pcm52/DRO-V6/README.md

# DRO-V6
Digital Readout sketch files for the Arduino IDE

Schematic and PCB layout files for both the DRO and Encoder boards in Eagle format.

See pcm52.com for more details on construction.
