pcm52/DRO-V6/encoder8.brd

## EAGLE design encoder8.brd (2020-05-19)

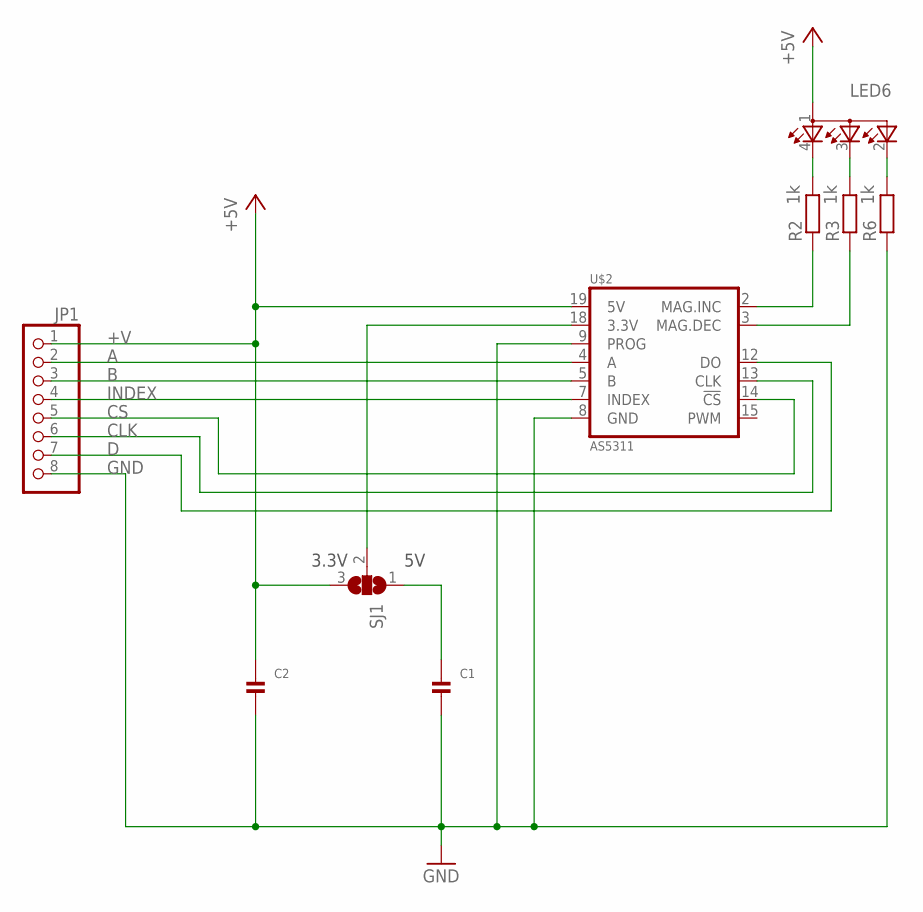
[picture p1: schematic encoder8.sch]

Parts:
C1, C2: CAP_CERAMIC0805; 0805
JP1: PINHD-1X8BIG; 1X08-BIG
LED6: RGB; RGB_LED_0805
R2, R3, R6: 1k; M0805
SJ1: SJ2W; SJ_2
U$2: AS5311; TSSOP.20

Connections:
+5V: LED6.1 (CA)
+V: C2.1, JP1.1, SJ1.3, U$2.19 (5V)
A: JP1.2, U$2.4 (A)
B: JP1.3, U$2.5 (B)
CLK: JP1.6, U$2.13 (CLK)
CS: JP1.5, U$2.14 (!CS)
D: JP1.7, U$2.12 (DO)
DEC: R3.1, U$2.3 (MAG.DEC)
GND: C1.2, C2.2, JP1.8, R6.1, U$2.8 (GND), U$2.9 (PROG)
INC: R2.1, U$2.2 (MAG.INC)
INDEX: JP1.4, U$2.7 (INDEX)
unnamed: C1.1, SJ1.1
unnamed: LED6.4 (CRED), R2.2
unnamed: LED6.3 (CGREEN), R3.2
unnamed: LED6.2 (CBLUE), R6.2
unnamed: SJ1.2, U$2.18 (3.3V)

Notes on the sheet:
3.3V

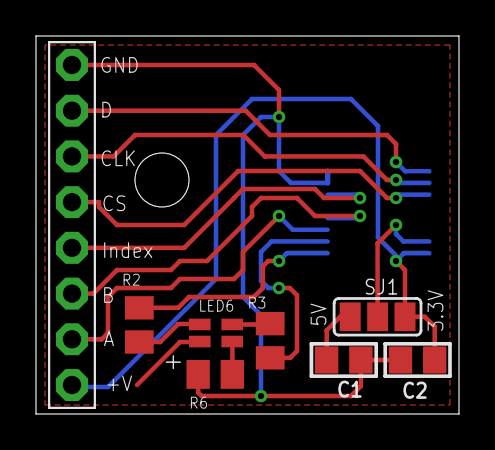
[picture p2: board encoder8.brd from above]

Board: 2 copper layers, 23.5 x 21.0 mm, 9 parts (1 on the bottom side), 15 nets.
