pcm52/DRO-V6/2.2_128x32_OLED-SPI-DRO-FTDI-6.brd

## EAGLE design 2.2_128x32_OLED-SPI-DRO-FTDI-6.brd (2020-05-19)

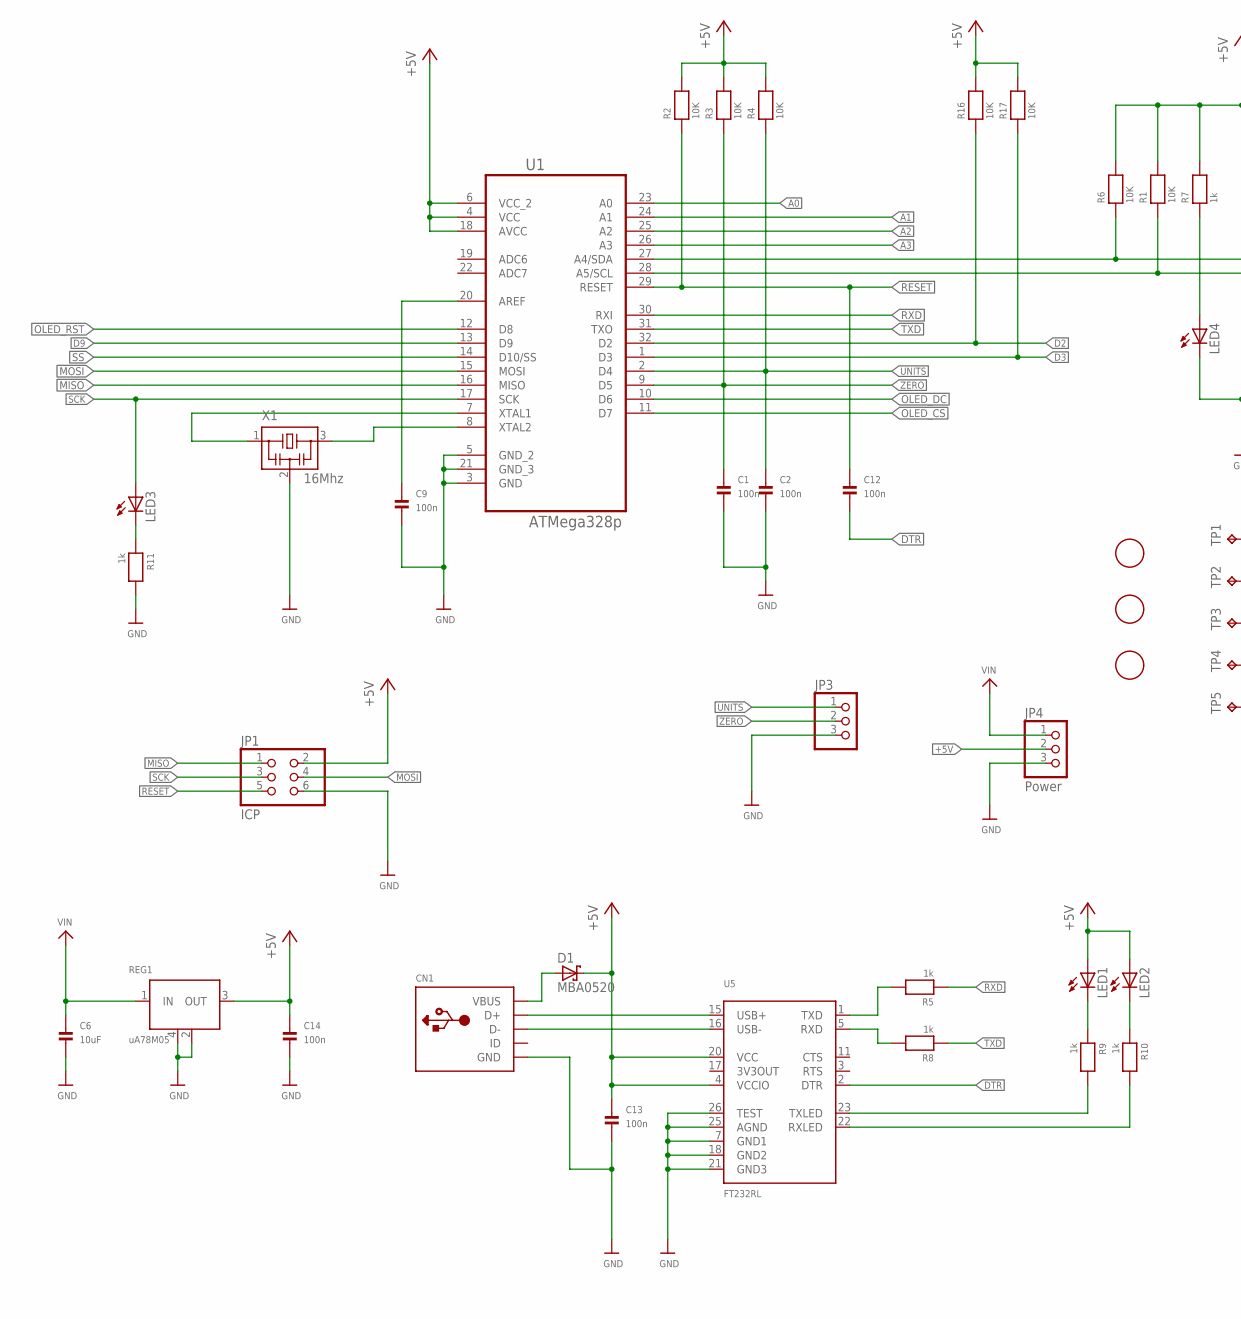
[picture p3: schematic 2.2_128x32_OLED-SPI-DRO-FTDI-6.sch, part in row 1, column 1]

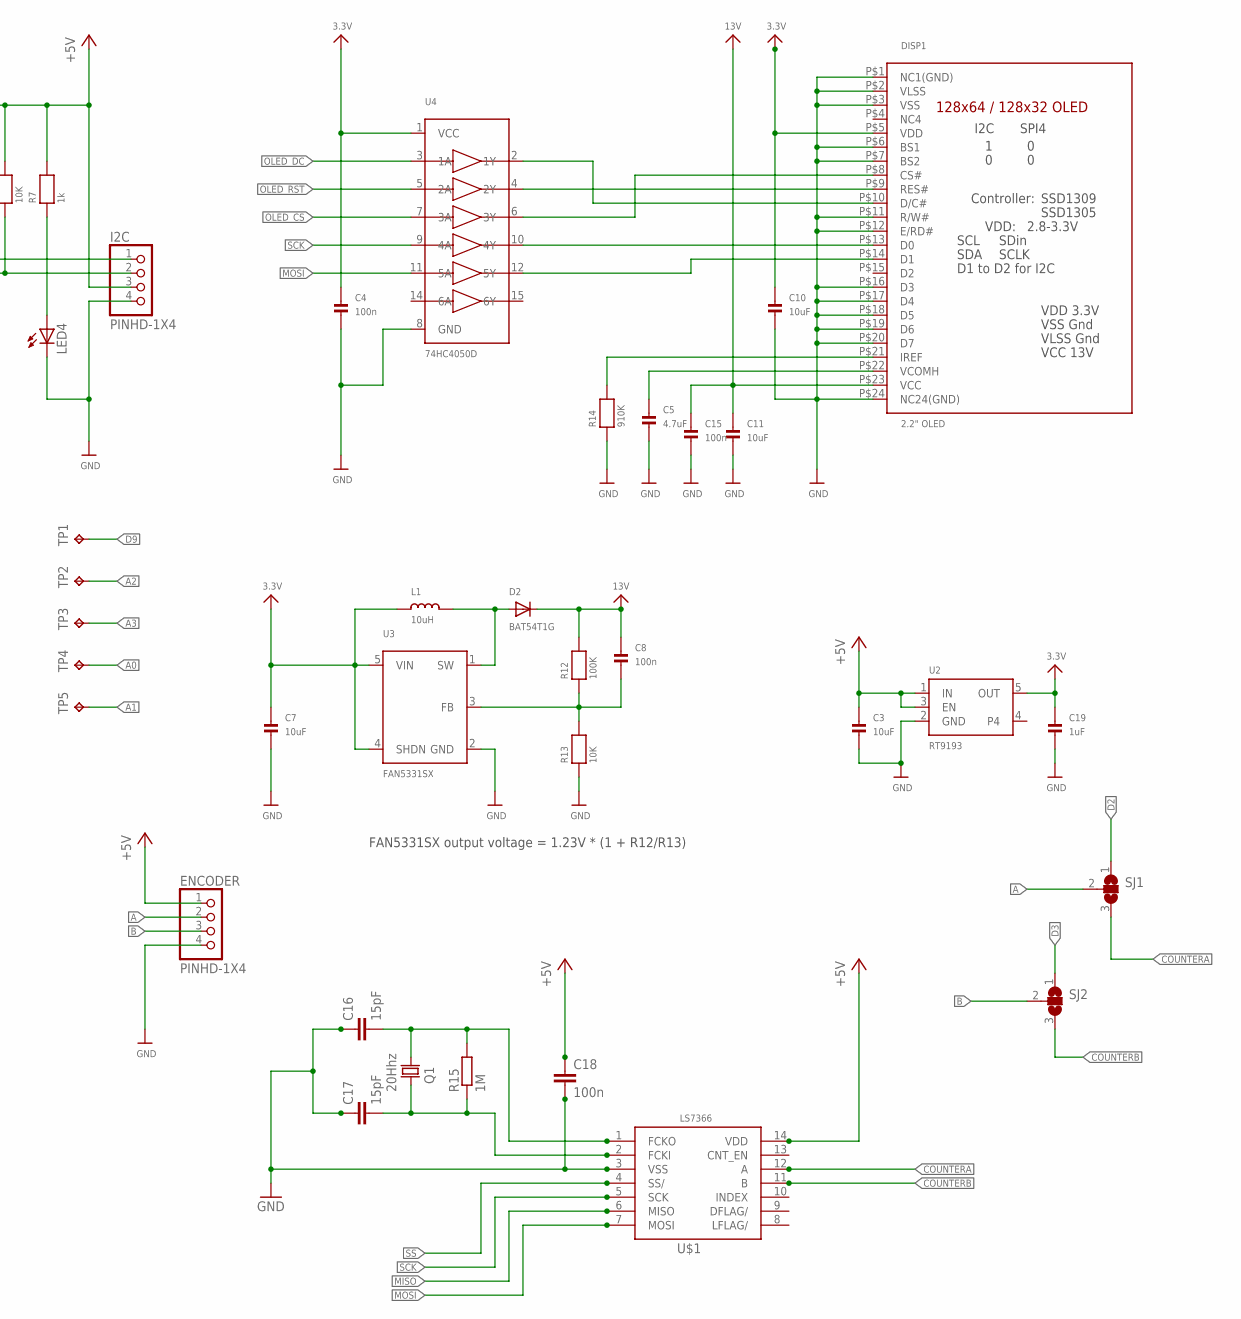
[picture p4: schematic 2.2_128x32_OLED-SPI-DRO-FTDI-6.sch, part in row 1, column 2]

Parts:
C1, C2, C4, C8, C9, C12, C13, C14, C15: 100n; 0805
C3, C6, C7, C10, C11: 10uF; 0805
C5: 4.7uF; 0805
C16, C17: 15pF; C0805
C18: 100n; C0805
C19: 1uF; 0805
CN1: USBMINIB; USB-MINIB
D1: MBA0520; SOD123
D2: BAT54T1G; SOD-123
DISP1: 2.2" OLED; 1.5-128X64-TOP-CONTACT
ENCODER: PINHD-1X4; 1X04-BIG
I2C: PINHD-1X4; 1X04-BIG
JP1: ICP; 2X03
JP3: PINHD-1X3; 1X03
JP4: Power; 1X03
L1: 10uH; INDUCTOR_1007
LED1, LED2, LED3, LED4: LEDCHIPLED_0805; CHIPLED_0805
Q1: 20Hhz; F6-XTAL
R1, R2, R3, R4, R6, R13, R16, R17: 10K; 0805
R5, R7, R8, R9, R10, R11: 1k; 0805
R12: 100K; 0805
R14: 910K; 0805
R15: 1M; M0805
REG1: uA78M05; UA78M05
SJ1, SJ2: SJ2W; SJ_2
TP1, TP2, TP3, TP4, TP5: TPTP08R; TP08R
U1: ATMega328p; TQFP-32
U2: RT9193; SOT23-5
U3: FAN5331SX; SOT23-5
U4: 74HC4050D; SOIC16
U5: FT232RL; SSOP28DB
U$1: LS7366; SO14
U$2, U$6, U$28: FIDUCIAL; FIDUCIAL_1MM
X1: 16Mhz; CSTCE-CRYSTAL-OSC

Connections:
3.3V: C4.1, C7.1, C10.1, C19.1, DISP1.P$5 (VDD), L1.P$1 (1), U2.5 (OUT), U3.4 (SHDN), U3.5 (VIN), U4.1 (VCC)
3V3OUT: U5.17 (3V3OUT)
13V: C8.1, C11.1, C15.1, D2.C, DISP1.P$23 (VCC), R12.2
+5V: C3.1, C13.1, C14.1, C18.1, D1.C, ENCODER.1, I2C.3, JP1.2, JP4.2, LED1.A, LED2.A, R1.2, R2.2, R3.2, R4.2, R6.2, R7.2, R16.2, R17.2, REG1.3 (OUT), U1.4 (VCC), U1.6 (VCC_2), U1.18 (AVCC), U2.1 (IN), U2.3 (EN), U5.4 (VCCIO), U5.20 (VCC), U$1.14 (VDD)
A: ENCODER.2, SJ1.2
A0: TP4.TP, U1.23 (A0)
A1: TP5.TP, U1.24 (A1)
A2: TP2.TP, U1.25 (A2)
A3: TP3.TP, U1.26 (A3)
B: ENCODER.3, SJ2.2
COUNTERA: SJ1.3, U$1.12 (A)
COUNTERB: SJ2.3, U$1.11 (B)
CS: DISP1.P$8 (CS#), U4.6 (3Y)
D0: DISP1.P$13 (D0), U4.10 (4Y)
D1: DISP1.P$14 (D1), U4.12 (5Y)
D2: R16.1, SJ1.1, U1.32 (D2)
D3: R17.1, SJ2.1, U1.1 (D3)
D9: TP1.TP, U1.13 (D9)
DC: DISP1.P$10 (D/C#), U4.2 (1Y)
DTR: C12.2, U5.2 (DTR)
GND: C1.2, C2.2, C3.2, C4.2, C5.2, C6.2, C7.2, C9.2, C10.2, C11.2, C13.2, C14.2, C15.2, C16.1, C17.1, C18.2, C19.2, CN1.GND, DISP1.P$1 (NC1(GND)), DISP1.P$2 (VLSS), DISP1.P$3 (VSS), DISP1.P$6 (BS1), DISP1.P$7 (BS2), DISP1.P$11 (R/W#), DISP1.P$12 (E/RD#), DISP1.P$16 (D3), DISP1.P$17 (D4), DISP1.P$18 (D5), DISP1.P$19 (D6), DISP1.P$20 (D7), DISP1.P$24 (NC24(GND)), ENCODER.4, I2C.4, JP1.6, JP3.3, JP4.3, LED4.C, R11.2, R13.1, R14.1, REG1.2 (COMMON1), REG1.4 (COMMON2), U1.3 (GND), U1.5 (GND_2), U1.21 (GND_3), U2.2 (GND), U3.2 (GND), U4.8 (GND), U5.7 (GND1), U5.18 (GND2), U5.21 (GND3), U5.25 (AGND), U5.26 (TEST), U$1.3 (VSS), X1.2
MISO: JP1.1, U1.16 (MISO), U$1.6 (MISO)
MOSI: JP1.4, U1.15 (MOSI), U4.11 (5A), U$1.7 (MOSI)
unnamed: D2.A, L1.P$2 (2), U3.1 (SW)
unnamed: U1.7 (XTAL1), X1.1
unnamed: DISP1.P$21 (IREF), R14.2
unnamed: C8.2, R12.1, R13.2, U3.3 (FB)
unnamed: C5.1, DISP1.P$22 (VCOMH)
unnamed: U1.8 (XTAL2), X1.3
unnamed: C9.1, U1.20 (AREF)
unnamed: CN1.D+, U5.15 (USB+)
unnamed: CN1.D-, U5.16 (USB-)
unnamed: CN1.VBUS, D1.A
unnamed: R5.2, U5.1 (TXD)
unnamed: R8.2, U5.5 (RXD)
unnamed: R9.2, U5.23 (TXLED)
unnamed: R10.2, U5.22 (RXLED)
unnamed: LED3.C, R11.1
unnamed: LED1.C, R9.1
unnamed: LED2.C, R10.1
unnamed: LED4.A, R7.1
unnamed: C16.2, Q1.P$2 (2), R15.2, U$1.1 (FCKO)
unnamed: C17.2, Q1.P$1 (1), R15.1, U$1.2 (FCKI)
OLED_CS: U1.11 (D7), U4.7 (3A)
OLED_DC: U1.10 (D6), U4.3 (1A)
OLED_RST: U1.12 (D8), U4.5 (2A)
RES: DISP1.P$9 (RES#), U4.4 (2Y)
RESET: C12.1, JP1.5, R2.1, U1.29 (RESET)
RXD: R5.1, U1.30 (RXI)
SCK: JP1.3, LED3.A, U1.17 (SCK), U4.9 (4A), U$1.5 (SCK)
SCL: I2C.2, R1.1, U1.28 (A5/SCL)
SDA: I2C.1, R6.1, U1.27 (A4/SDA)
SS: U1.14 (D10/SS), U$1.4 (SS/)
TXD: R8.1, U1.31 (TXO)
UNITS: C2.1, JP3.1, R4.1, U1.2 (D4)
VIN: C6.1, JP4.1, REG1.1 (IN)
ZERO: C1.1, JP3.2, R3.1, U1.9 (D5)

Notes on the sheet:
FAN5331SX output voltage = 1.23V * (1 + R12/R13)

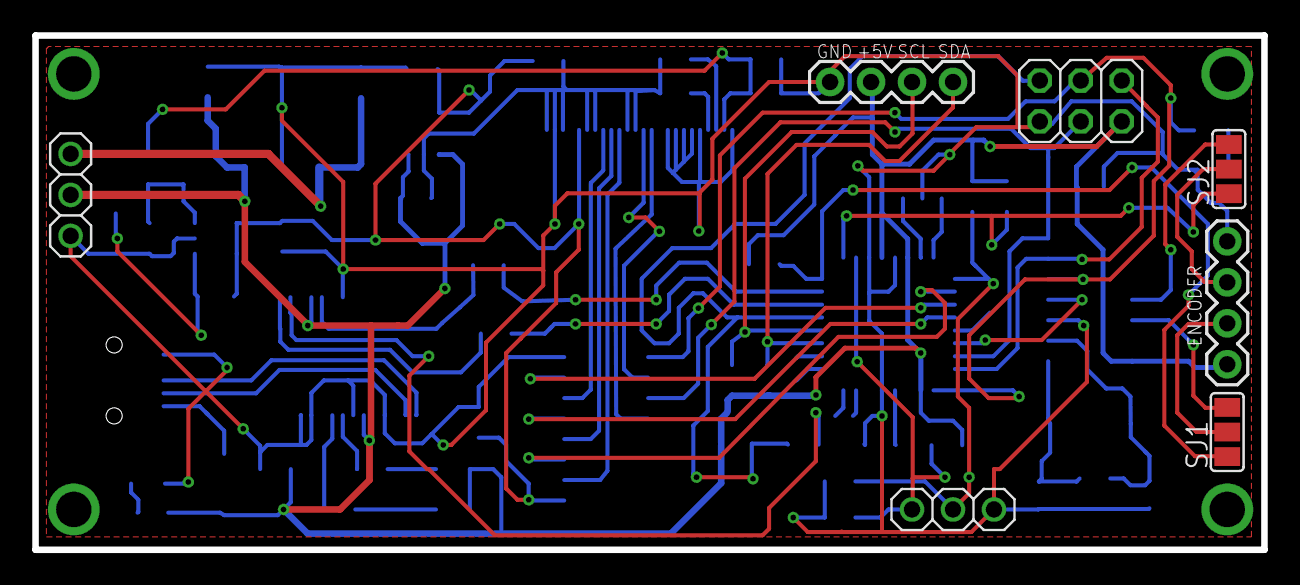
[picture p5: board 2.2_128x32_OLED-SPI-DRO-FTDI-6.brd from above]

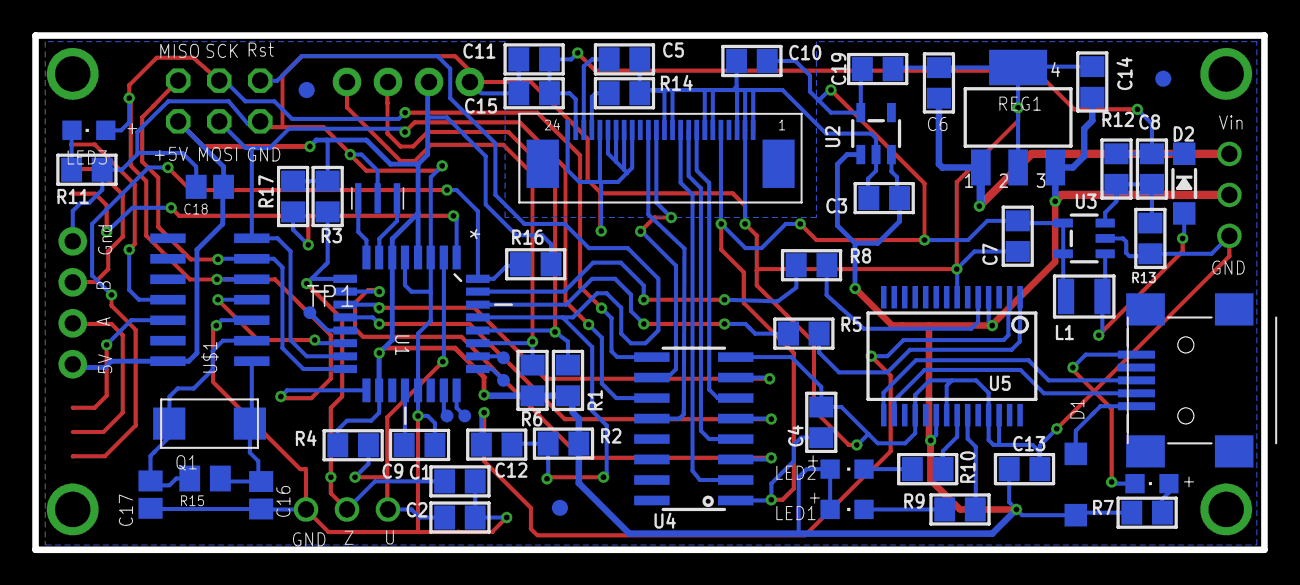
[picture p6: board 2.2_128x32_OLED-SPI-DRO-FTDI-6.brd from below]

Board: 2 copper layers, 76.2 x 31.9 mm, 69 parts (62 on the bottom side), 56 nets.
