pcm52/DRO-V6/(threads)

Thread 1 (2023-01-13):

touch dro

Traktorist3d, 2023-01-13:
Hi, I have as5311 sensors and would like to repeat your design. But I would like to work with data through touch dro. Do you have any idea how you can use your project + touch dro?

Olabec, 2023-01-13:
You don't need my project for touch DRO. The AS5311 has quadrature outputs. You could connect these directly to to their ESP32 based interface board as described on their website.

Traktorist3d, 2023-01-13:
Well, what about your sensor boards, can I use them for this?

Olabec, 2023-01-14:
Yes, the DRO-V6 board should work with the touch DRO interface.

Traktorist3d, 2023-01-14:
It's great, but I can't figure it out. In the photo of your encoder, there is an as5311 chip on one board, and on the other side there are many more elements, including another microcircuit. But the diagram shows only as5311. I see a crystal oscillator and so on. Just a stock board from AMS - as5311-ab contains only AS5311 and some capacitors. And I don’t understand, should I take your fee as a basis or draw stock from AMS

Olabec, 2023-01-16:
I think you are looking at an early version of the encoder on the PCM52.com site. Use the eagle sch and brd files here on github for encoder8. The early version has an additional LS7366 quad counter and crystal.

Traktorist3d, 2023-01-16:
Yes, I opened it, thank you very much for the free access to your development. I will send the prints. The only thing that confuses me is only one hole in the board for fasteners. In the old version you had 4 holes. And minimal margins along the edges of the board for pressing against the case. After all, there will still be elements sticking out (capacitors, etc.), if I'm not mistaken, the sensors should all be rigid in the case for fine-grained data display. Or is one hole enough?

Traktorist3d, 2023-01-16:
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
Is there a mistake in the screenshot? 5 volt wire not connected

Closed 2023-01-13.
